AnthonyDiGirolamo/lightsout/images/IMG_3848.JPG

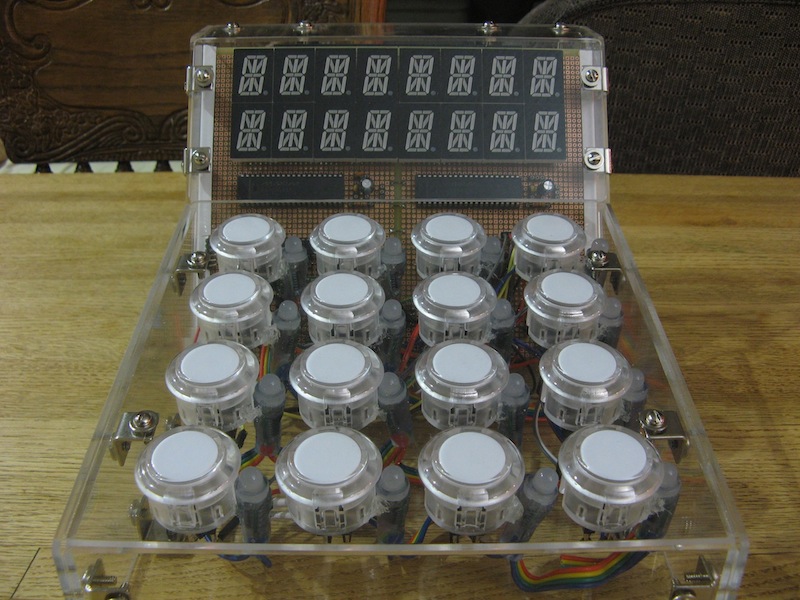
images/IMG_3848.JPG
