AnthonyDiGirolamo/lightsout/images/IMG_3853.JPG

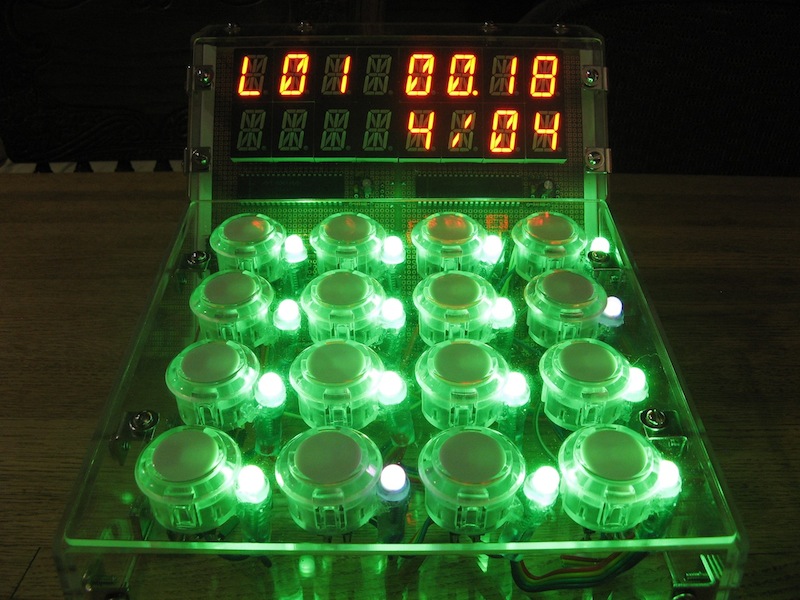
images/IMG_3853.JPG
