AnthonyDiGirolamo/lightsout/images/IMG_3854.JPG

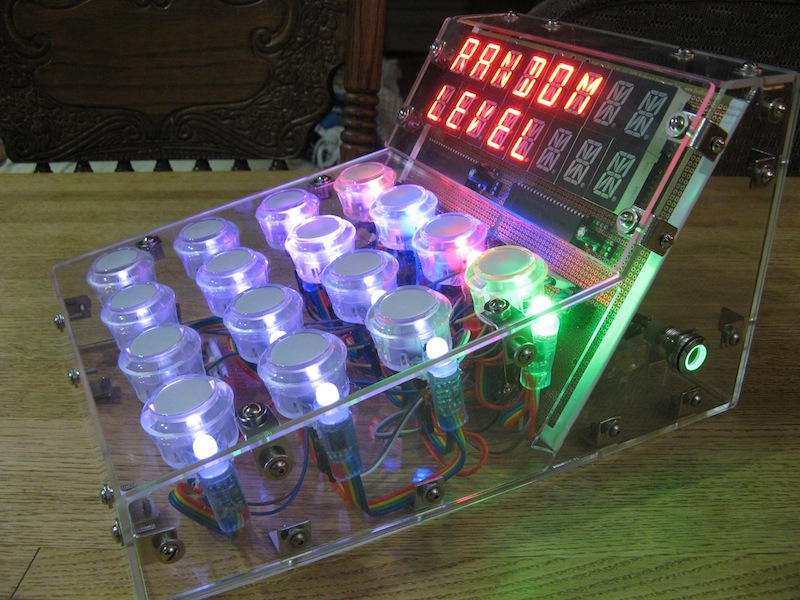
images/IMG_3854.JPG
