AnthonyDiGirolamo/lightsout/images/IMG_3856.JPG

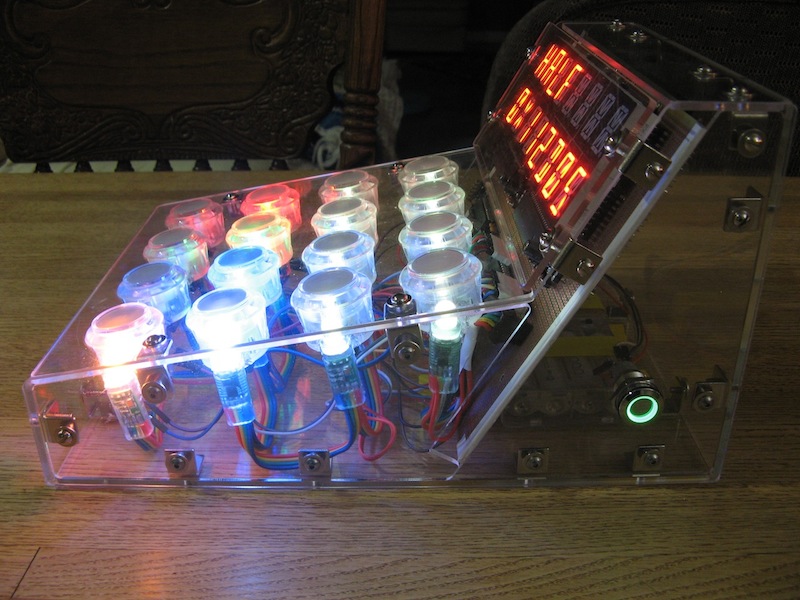
images/IMG_3856.JPG
