AnthonyDiGirolamo/lightsout/images/IMG_3857.JPG

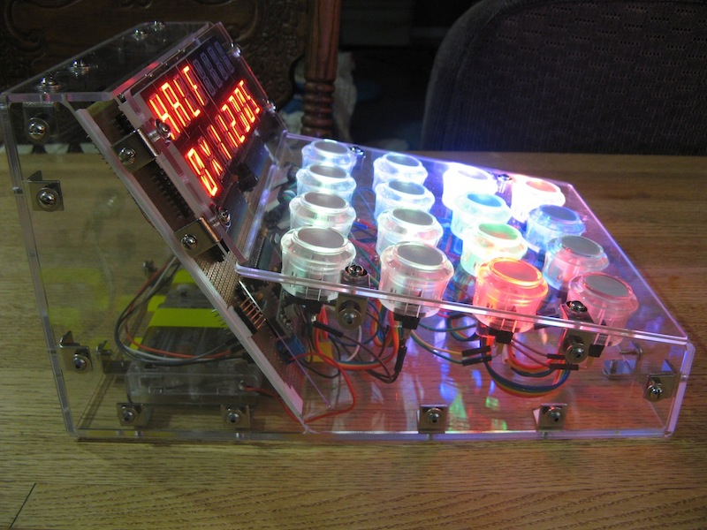
images/IMG_3857.JPG
