AnthonyDiGirolamo/lightsout/images/IMG_3866.JPG

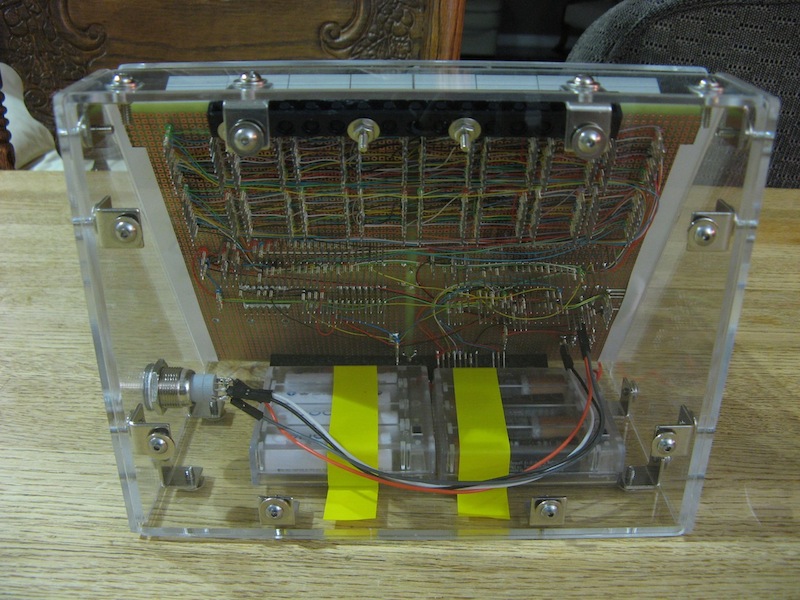
images/IMG_3866.JPG
