AnthonyDiGirolamo/lightsout/images/IMG_3868.JPG

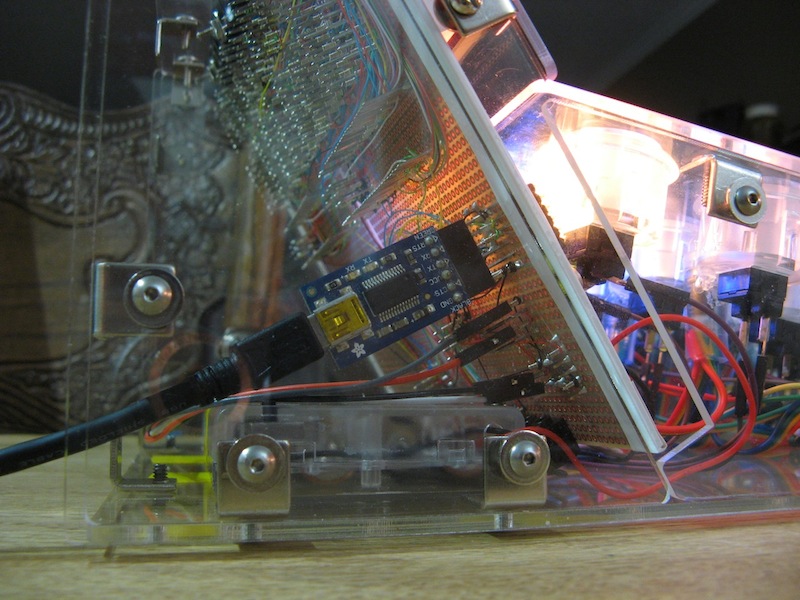
images/IMG_3868.JPG
