AnthonyDiGirolamo/lightsout/images/IMG_3870.JPG

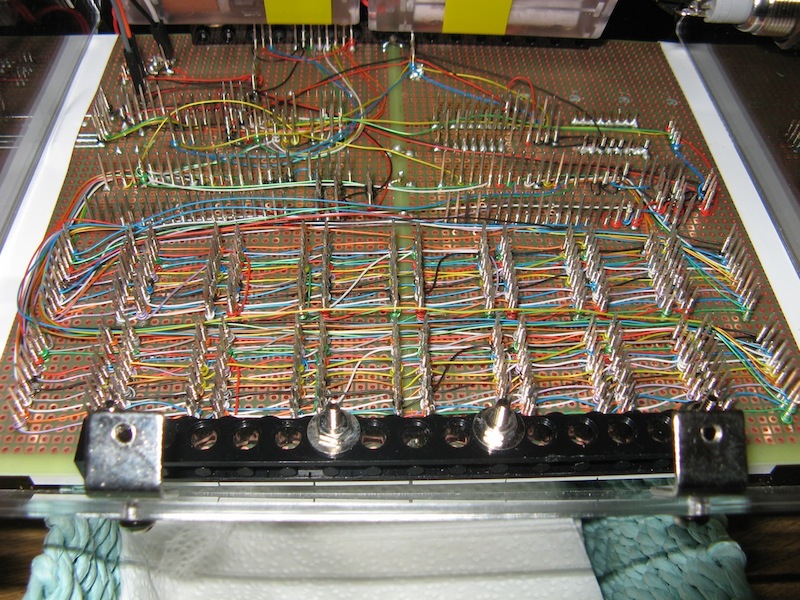
images/IMG_3870.JPG
