AnthonyDiGirolamo/lightsout/images/IMG_3871.JPG

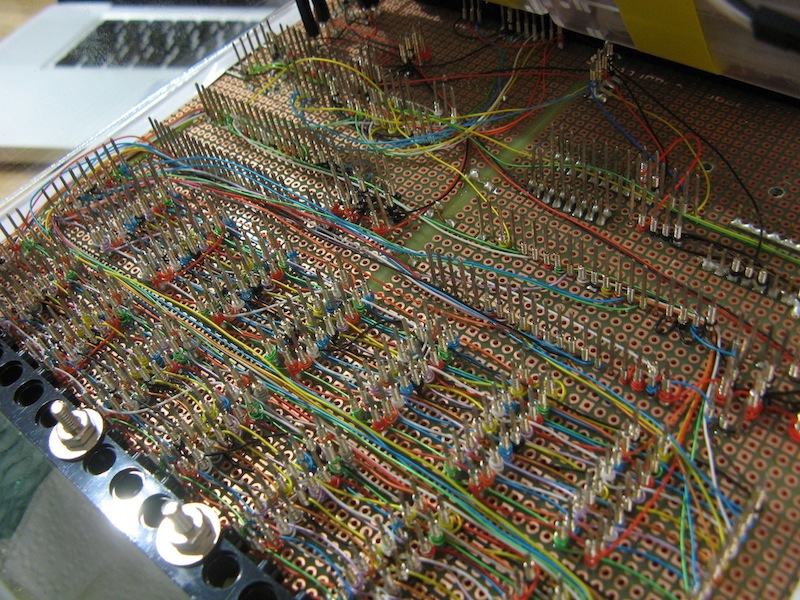
images/IMG_3871.JPG
