AnthonyDiGirolamo/lightsout/images/IMG_3872.JPG

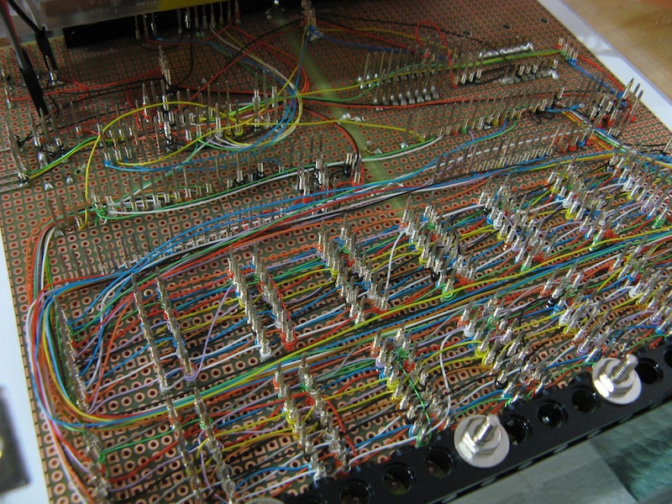
images/IMG_3872.JPG
