AnthonyDiGirolamo/lightsout/images/IMG_3873.JPG

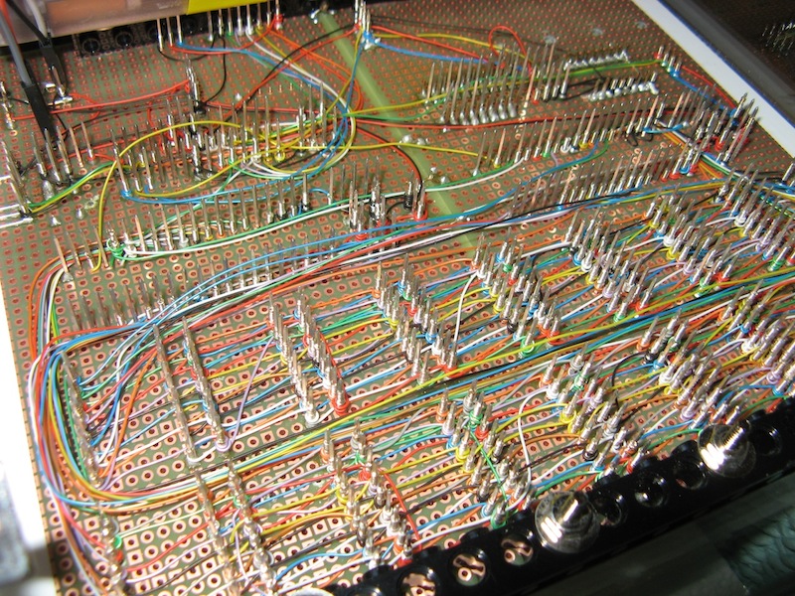
images/IMG_3873.JPG
