AnthonyDiGirolamo/lightsout/lightsout_99_setup_loop.ino

void setup() {
  /* Serial.begin(9600); */
  Serial.begin(57600);

  // Setup 16-segment display
  alpha_board.begin();
  alpha_board.set_global_brightness(4);

  // Setup RGB Strip
  strip.begin();
  strip.show();

  // Turn on I2C
  Wire.begin();

  // Setup the RTC
  RTC.begin();

  if (! RTC.isrunning()) {
    Serial.println("RTC is NOT running!");
    // following line sets the RTC to the date & time this sketch was compiled
    RTC.adjust(DateTime(__DATE__, __TIME__));
  }

  DateTime now = RTC.now();
  DateTime compiled = DateTime(__DATE__, __TIME__);
  if (now.unixtime() <= compiled.unixtime()) {
    //Serial.println("RTC is older than compile time!  Updating");
    // RTC.adjust(DateTime(__DATE__, __TIME__));
    // RTC.adjustTime(-7 * SECS_PER_HOUR); // PST
    // RTC.adjustTime(-8 * SECS_PER_HOUR); // PST in daylight savings
    // RTC.adjustTime(-5 * SECS_PER_HOUR); // EST
    // RTC.adjustTime(-4 * SECS_PER_HOUR); // EST in daylight savings
    // RTC.adjust(DateTime(compiled.unixtime() - 2*60*60));
    RTC.adjust(compiled.unixtime());
  }


  // Setup port expander
  mcp.begin();
  for (int i=0; i<16; i++) {
    mcp.pinMode(i, INPUT);
    mcp.pullUp(i, HIGH);  // turn on a 100K pullup internally
  }

  /* delay(5000); */
  /* for (int i=0; i< 32; i++) { */
  /*   Serial.println(mini_lightsout_levels[i], BIN); */
  /* } */

  main_menu();
}

void main_menu() {
  int i = 1, button = 0;
  unsigned long time = millis();

  max_print_progmem(string_lights, 0, 0);
  max_print_progmem(string_out, 1, 0);

  colorWipe(main_menu_color_schemes[current_scheme], 0);

  // Set Dim Colors
  for (int x=0; x<3; x++)
    set_strip_with_gamma_correction(board_light_index[15-x], main_menu_color_schemes_dim[current_scheme+1+x]);
  strip.show();

  // Animation here
  uint32_t lit_color;
  EEPROM_readAnything(0, lit_color);

  // Wipe Upper Left to Lower Right
  for (int x=0; x<7; x++) { print_board(animation1[x],  lit_color); delay(50); }
  for (int x=0; x<7; x++) { print_board(~animation1[x], lit_color); delay(50); }
  print_board(animation1[0], lit_color);

  // Wipe Upper Right to Lower Left
  for (int x=0; x<7; x++) { print_board(animation2[x],  lit_color); delay(50); }
  for (int x=0; x<7; x++) { print_board(~animation2[x], lit_color); delay(50); }
  print_board(animation2[0], lit_color);

  while (1) {
    // if MENU_DELAY time has elapsed
    if (millis() - time > MENU_DELAY) {
      if (i == 1) {
        max_print_progmem(string_clock, 0, 0);
        max_print_progmem(string_empty, 1, 0);
      }
      else if (i == 2) {
        max_print_progmem(string_lights, 0, 0);
        max_print_progmem(string_out, 1, 0);
      }
      else if (i == 3) {
        max_print_progmem(string_color, 0, 0);
        max_print_progmem(string_picker, 1, 0);
      }

      // Set Dim Colors
      for (int x=0; x<3; x++)
        set_strip_with_gamma_correction(board_light_index[15-x], main_menu_color_schemes_dim[current_scheme+1+x]);

      // Highlight Current Menu Option
      set_strip_with_gamma_correction(board_light_index[16-i], main_menu_color_schemes[current_scheme+i]);
      strip.show();

      i++;
      if (i>3)
        i=1;
      time = millis();
    }

    check_switches();

    if (justpressed[15]) {
      Clock cm = Clock();
      cm.begin();
      delete &cm;
      alpha_board.enable_decode_mode();
      colorWipe(0x000000, 0);
    }

    else if (justpressed[14]) {
      LightsOut game = LightsOut();
      game.begin();
    }

    else if (justpressed[13]) {
      ColorPicker cp = ColorPicker();
      cp.begin();
    }

  } // end while
}

void loop() {
}

// vim: ft=cpp
