AnthonyDiGirolamo/lightsout/lightsout_01_vars.ino

// Components Setup

#define STRIP_CLK  6
#define STRIP_DATA 5
#define CS1        9  // MAX6954 1
#define CS2        8  // MAX6954 2
#define DATAOUT    11 // MOSI
#define DATAIN     12 // MISO
#define CLK        13 // sck

Adafruit_WS2801 strip = Adafruit_WS2801(16, STRIP_DATA, STRIP_CLK);

MAX6954 alpha_board = MAX6954(DATAOUT, DATAIN, CLK, CS1, CS2);
typedef void (MAX6954::*alpha_board_method)(byte address, byte value);

Adafruit_MCP23017 mcp;

RTC_DS3231 RTC;

#define LIGHT_SENSOR_PIN 3

// Number Constants

#define RANDOMSEED1 31415926ul
#define RANDOMSEED2 62831852ul

// Strings

const char string_empty[]    PROGMEM = "                ";

// Main Menu
const char string_mainmenu1[] PROGMEM = "Main    ";
const char string_mainmenu2[] PROGMEM = "Menu    ";
const char string_lights[]   PROGMEM = "Lights  ";
const char string_out[]      PROGMEM = "Out     ";
const char string_color[]    PROGMEM = "Color   ";
const char string_picker[]   PROGMEM = "Chooser ";
const char string_calc[]     PROGMEM = "Calc    ";
const char string_clock[]    PROGMEM = "Clock   ";

// Lights Out
const char string_paused[]   PROGMEM = "Paused  ";
const char string_you[]      PROGMEM = "You";
const char string_win[]      PROGMEM = "Win";
const char string_perfect[]  PROGMEM = "Perfect ";
const char string_level[]    PROGMEM = "Level   ";
const char string_levels[]   PROGMEM = "Levels  ";
const char string_board[]    PROGMEM = "Board   ";
const char string_solution[] PROGMEM = "Solution";
const char string_restart[]  PROGMEM = "Restart ";
const char string_next[]     PROGMEM = "Next    ";
const char string_prev[]     PROGMEM = "Previous";
const char string_moves[]    PROGMEM = "Moves   ";
const char string_random[]   PROGMEM = "Random  ";
const char string_normal[]   PROGMEM = "Normal  ";
const char string_cancel[]   PROGMEM = "Resume  ";

// Color Chooser
const char string_fade[]     PROGMEM = "Rainbow ";
const char string_full[]     PROGMEM = "Full    ";
const char string_half[]     PROGMEM = "Half    ";
const char string_saved[]    PROGMEM = "Saved   ";

// Clock
const char string_mon[]   PROGMEM = "Monday  ";
const char string_tue[]   PROGMEM = "Tuesday ";
const char string_wed[]   PROGMEM = "Wednesday";
const char string_thu[]   PROGMEM = "Thursday";
const char string_fri[]   PROGMEM = "Friday  ";
const char string_sat[]   PROGMEM = "Saturday";
const char string_sun[]   PROGMEM = "Sunday  ";
const char* const string_days[] PROGMEM = {string_sun, string_mon, string_tue, string_wed, string_thu, string_fri, string_sat};

const char string_moon0[] PROGMEM = "New Moon";
const char string_moon1[] PROGMEM = "    Moon";
const char string_moon2[] PROGMEM = "HalfMoon";
const char string_moon3[] PROGMEM = "    Moon";
const char string_moon4[] PROGMEM = "FullMoon";
const char string_moon5[] PROGMEM = "    Moon";
const char string_moon6[] PROGMEM = "HalfMoon";
const char string_moon7[] PROGMEM = "    Moon";
const char* const string_moon_phases[] PROGMEM = {string_moon0, string_moon1, string_moon2, string_moon3, string_moon4, string_moon5, string_moon6, string_moon7};

uint32_t minute_colors[] = {
  0x00FFFF,
  0xFFCC00,
};
uint32_t hour_colors[] = {
  0x3366FF,
  0xFF6600,
};

uint8_t animation_hourglass[15][2] = {
  {0, B00000010},
  {0, B00000110},
  {0, B10000110},
  {0, B10001110},
  {0, B10011110},
  {0, B10111110},
  {8, B00000001},
  {8, B00000011},
  {8, B00000111},
  {8, B01000111},
  {0, B10111111},
  {8, B01100111},
  {8, B01110111},
  {8, B01111111},
  {8, B11111111},
};

#define MENU_DELAY 1000

// Color Schemes
uint32_t main_menu_color_schemes[] = {
  0x000000, // off
  0xFF9000, // item 1
  0x0000FF, // item 2
  0xFF0000, // item 3
  0x00FF00, // item 4
  0xFF00FF, // item 5
};

uint32_t main_menu_color_schemes_dim[] = {
  0x000000, // off
  0x401800, // item 1
  0x000040, // item 2
  0x400000, // item 3
  0x004000, // item 4
  0x400040, // item 5
};

uint32_t lights_out_color_schemes[] = {
  0xFF9000, // on
  0x000000, // off
  0x000080, // on
  0x000000, // off
};
uint8_t current_scheme = 0; // index of on color in color_schemes array

// Lookup Tables

uint16_t space_masks[] = {
  0x1,
  0x2,
  0x4,
  0x8,
  0x10,
  0x20,
  0x40,
  0x80,
  0x100,
  0x200,
  0x400,
  0x800,
  0x1000,
  0x2000,
  0x4000,
  0x8000
};

uint8_t neighbors[16][4] = {
// N   S   E   W
  {4,  12, 3,  1},
  {5,  13, 0,  2},
  {6,  14, 1,  3},
  {7,  15, 2,  0},
  {8,  0,  7,  5},
  {9,  1,  4,  6},
  {10, 2,  5,  7},
  {11, 3,  6,  4},
  {12, 4,  11, 9},
  {13, 5,  8,  10},
  {14, 6,  9,  11},
  {15, 7,  10, 8},
  {0,  8,  15, 13},
  {1,  9,  12, 14},
  {2,  10, 13, 15},
  {3,  11, 14, 12}
};

// 15 14 13 12
// 11 10 9  8
// 7  6  5  4
// 3  2  1  0

uint8_t board_light_index[] = {
  15,
  14,
  13,
  12,
  8,
  9,
  10,
  11,
  7,
  6,
  5,
  4,
  0,
  1,
  2,
  3
};

// Strand Board Indexes
// 15 14 13 12
// 11 10 9  8
// 7  6  5  4
// 3  2  1  0

// Strand Hardware Indexes
// 3  2  1  0
// 4  5  6  7
// 11 10 9  8
// 12 13 14 15

// Strand Spiral Indexes
// 3  2  1  0
// 4  13 12 11
// 5  14 15 10
// 6  7  8  9

uint8_t spiral_light_index[] = {
  0,
  1,
  2,
  3,
  4,
  11,
  12,
  13,
  14,
  15,
  8,
  7,
  6,
  5,
  10,
  9,
};

// Matrix for solving a given lights out game
// This is a matrix of 1's and 0's packed into 16 bit integers

uint16_t solving_matrix[] = {
  0xD808,
  0xE404,
  0x7202,
  0xB101,
  0x8D80,
  0x4E40,
  0x2720,
  0x1B10,
  0x8D8,
  0x4E4,
  0x272,
  0x1B1,
  0x808D,
  0x404E,
  0x2027,
  0x101B
};

// uint16_t uint16_t matrix_a[16][16] = {
//   {1,1,0,1,1,0,0,0,0,0,0,0,1,0,0,0},
//   {1,1,1,0,0,1,0,0,0,0,0,0,0,1,0,0},
//   {0,1,1,1,0,0,1,0,0,0,0,0,0,0,1,0},
//   {1,0,1,1,0,0,0,1,0,0,0,0,0,0,0,1},
//   {1,0,0,0,1,1,0,1,1,0,0,0,0,0,0,0},
//   {0,1,0,0,1,1,1,0,0,1,0,0,0,0,0,0},
//   {0,0,1,0,0,1,1,1,0,0,1,0,0,0,0,0},
//   {0,0,0,1,1,0,1,1,0,0,0,1,0,0,0,0},
//   {0,0,0,0,1,0,0,0,1,1,0,1,1,0,0,0},
//   {0,0,0,0,0,1,0,0,1,1,1,0,0,1,0,0},
//   {0,0,0,0,0,0,1,0,0,1,1,1,0,0,1,0},
//   {0,0,0,0,0,0,0,1,1,0,1,1,0,0,0,1},
//   {1,0,0,0,0,0,0,0,1,0,0,0,1,1,0,1},
//   {0,1,0,0,0,0,0,0,0,1,0,0,1,1,1,0},
//   {0,0,1,0,0,0,0,0,0,0,1,0,0,1,1,1},
//   {0,0,0,1,0,0,0,0,0,0,0,1,1,0,1,1} };


/* Mini Lights Out Levels */

uint16_t mini_lightsout_levels[] = {
  0xA0A0,
  0xA0A0,
  0xF99F,
  0x4422,
  0xEEEE,
  0xDCAC,
  0xF741,
  0xF7DE,
  0xF7EB,
  0xAAEE,
  0xDCCD,
  0xB5AD,
  0xCCEE,
  0x256C,
  0x6236,
  0xE63,
  0x91B1,
  0x9669,
  0x6996,
  0xFF00,
  0xD436,
  0x7D89,
  0x7D0D,
  0xA141,
  0x4BD9,
  0x884B,
  0xB424,
  0x6886,
  0x4A52,
  0x4820,
  0xA5A4,
  0x7FFF,
  0x4801
};

/* 1010000010100000 */
/* 1111100110011111 */
/* 0100010000100010 */
/* 1110111011101110 */
/* 1101110010101100 */
/* 1111011101000001 */
/* 1111011111011110 */
/* 1111011111101011 */
/* 1010101011101110 */
/* 1101110011001101 */
/* 1011010110101101 */
/* 1100110011101110 */
/* 0010010101101100 */
/* 0110001000110110 */
/* 0000111001100011 */
/* 1001000110110001 */
/* 1001011001101001 */
/* 0110100110010110 */
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
  115,117,119,120,122,124,126,127,129,131,133,135,137,138,140,142,
  144,146,148,150,152,154,156,158,160,162,164,167,169,171,173,175,
  177,180,182,184,186,189,191,193,196,198,200,203,205,208,210,213,
  215,218,220,223,225,228,231,233,236,239,241,244,247,249,252,255 };

// vim: ft=cpp
