AnthonyDiGirolamo/lightsout/lightsout_00_includes.ino

#include <avr/pgmspace.h>

#include <SPI.h>
#include "max6954.h"

#include "Adafruit_WS2801.h"

#include <Wire.h>
#include "Adafruit_MCP23017.h"
#include <RTClib.h>
#include <RTC_DS3231.h>

#include <EEPROM.h>
#include "EEPROMAnything.h"

//#include <stdio.h>
//#include <stdlib.h>
//#include <ctype.h>
//#include <math.h>

// vim: ft=cpp
