AnthonyDiGirolamo/lightsout/(commit log)

2012-06-29 Added lowercase printing to max6954, tiny change to lightsout
2012-07-01 Working towards outputting the game board onto the led pixels
2012-07-10 fixed read_buttons and completed color picker
    [lightsout_01_vars.ino]
2012-07-10 added colorpicker full board and fading toggles
2012-07-10 toggle whole board only if not fading
2012-07-10 cleaned up max printing, fading tweaks
2012-07-16 button timing changes
2012-07-16 int button! must be signed
2012-07-16 added pause menu and game timer for lightsout
2012-07-16 Fixes to pause menu, added a winning animation
    [lightsout_01_vars.ino, lightsout_02_helper_functions.ino, lightsout_04_lights_out_class.ino, lightsout_99_setup_loop.ino]
2015-10-09 added gamma correction option, added clock function
    [lightsout_00_includes.ino, lightsout_01_vars.ino, lightsout_02_helper_functions.ino, lightsout_03_color_picker_class.ino, lightsout_04_lights_out_class.ino, lightsout_06_clock_class.ino, lightsout_99_setup_loop.ino]
2015-10-10 row mode switching added to clock, new button checking code
2015-10-11 use new button implementation for the color picker
2015-10-12 switched lights out to use the newer button checker, reindented
2016-07-27 fix progmems to work with latest arduino ide
    [lightsout_01_vars.ino, lightsout_02_helper_functions.ino, lightsout_99_setup_loop.ino]
